lexxai/UltrasonicSensor/shema/shema-220.png

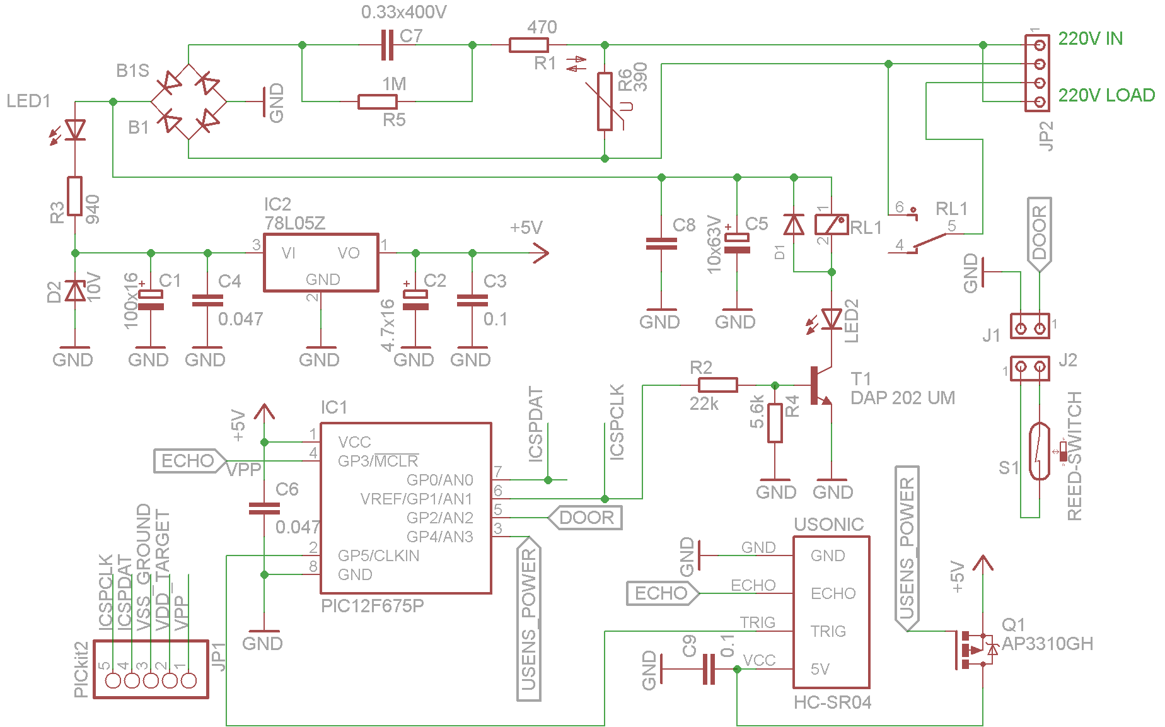
shema/shema-220.png
