lexxai/UltrasonicSensor/shema/ultrasonicsensor3.sch

## EAGLE design shema/ultrasonicsensor3.sch (2017-04-01)

Schematic: ultrasonicsensor3.sch

Parts:
C1: 50x10V; C/6032-28R
C3, C9: 0.1; C025-030X050
C5: 10x63V; C/6032-28R
C6: 0.047; C025-030X050
C8: C-EU025-030X050; C025-030X050
D1: DIODESOD-123; SOD-123
F1: SH22,5A
IC1: PIC12F675P; DIL8
J1, J2: MTA02-100; 10X02MTA
JP1: PICkit2; 1X05
JP2: MTA04-156; 1X4MTA
LED1, LED2, LED3: LED3MM
R2: 490R; 0207/2V
R4: 5.6k; 0207/2V
RL1: V23061-B1007-A401 SCHRACK; V23040201
S1: REED-SWITCH; MK6-5
T1: DAP 202 UM; TO92
USONIC: HC-SR04; HC-SR04_FOOTPRINT

Notes on the sheet:
220V LOAD
220V IN
Travel Charger Nokia AC-2E Input: ~ 100-240V/150mA Output: 5.3V/500mA
