lexxai/UltrasonicSensor/shema/ultrasonicsensor.sch

## EAGLE design shema/ultrasonicsensor.sch (2017-04-01)

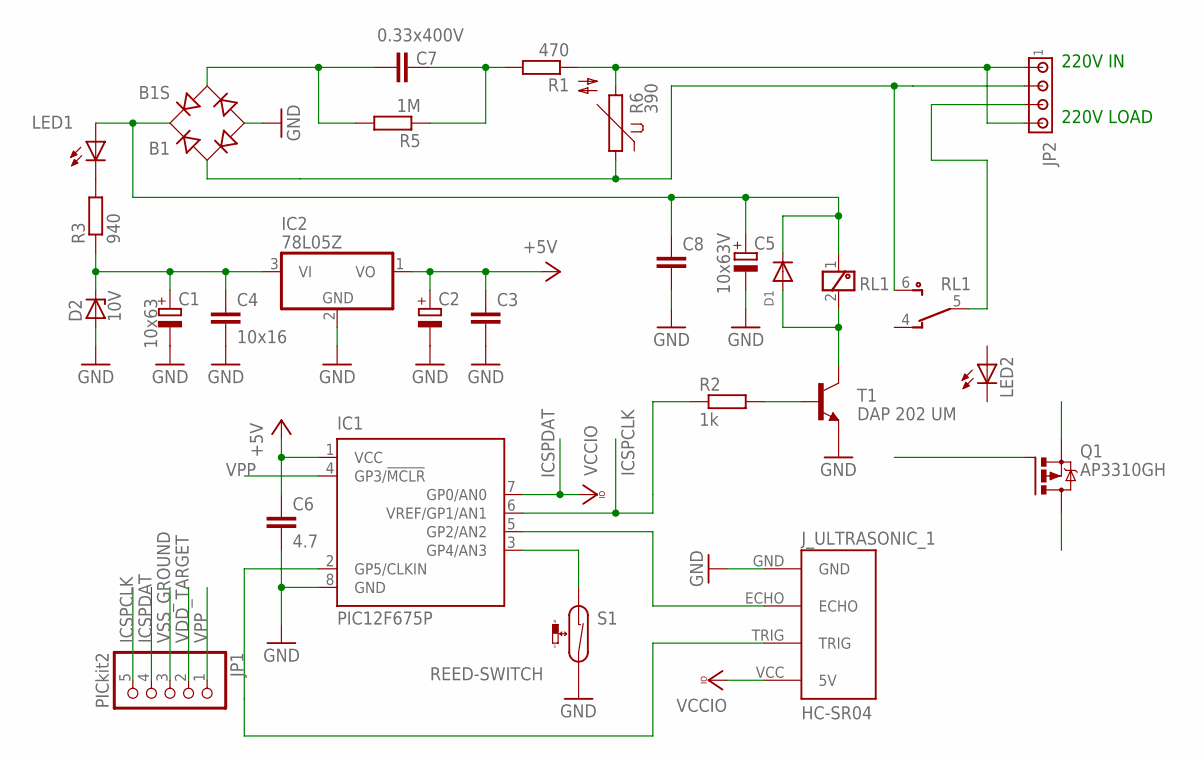
[picture p3: schematic ultrasonicsensor.sch]

Parts:
B1: B1S; MBS
C1: 10x63; C/6032-28R
C2: CPOL-EUC/6032-28R; C/6032-28R
C3, C8: C-EU025-030X050; C025-030X050
C4: 10x16; C025-030X050
C5: 10x63V; C/6032-28R
C6: 4.7; C025-030X050
C7: 0.33x400V; C025-030X050
D1: DIODESOD-123; SOD-123
D2: 10V; DO35Z10
IC1: PIC12F675P; DIL8
IC2: 78L05Z; TO92
JP1: PICkit2; 1X05
JP2: MTA04-156; 1X4MTA
J_ULTRASONIC_1: HC-SR04; HC-SR04_FOOTPRINT
LED1, LED2: LED3MM
R1: 470; 0207/2V
R2: 1k; 0207/2V
R3: 940; 0207/2V
R5: 1M; 0207/2V
R6: 390; S14K385
RL1: V23061-B1007-A401 SCHRACK; V23040201
S1: REED-SWITCH; MK6-5
T1: DAP 202 UM; TO92

Connections:
220-1: JP2.1, JP2.4, R1.1, R6.2
220-2: B1.AC1, JP2.2, R6.1, RL1.6
220-LOAD: JP2.3, RL1.5
+24V: C1.+, C4.1, D2.C, IC2.3 (VI), R3.1
GND: B1.-, C1.-, C2.-, C3.2, C4.2, C5.-, C6.2, C8.2, D2.A, IC1.8 (GND), IC2.2 (GND), J_ULTRASONIC_1.GND, S1.2, T1.1 (E)
ICSPCLK: IC1.6 (VREF/GP1/AN1), JP1.5, R2.1
ICSPDAT: IC1.7 (GP0/AN0), JP1.4
unnamed: IC1.5 (GP2/AN2), J_ULTRASONIC_1.ECHO
unnamed: IC1.2 (GP5/CLKIN), J_ULTRASONIC_1.TRIG
unnamed: R2.2, T1.2 (B)
unnamed: B1.+, C5.+, C8.1, D1.C, LED1.A, RL1.1
unnamed: IC1.3 (GP4/AN3), S1.1
unnamed: D1.A, RL1.2, T1.3 (C)
unnamed: LED1.K (C), R3.2
unnamed: C7.1, R1.2, R5.1
unnamed: B1.AC2, C7.2, R5.2
VCC: C2.+, C3.1, C6.1, IC1.1 (VCC), IC2.1 (VO)
VCCIO: J_ULTRASONIC_1.VCC (5V)
VDD_TARGET: JP1.2
VPP: IC1.4 (GP3/!MCLR), JP1.1
VSS_GROUND: JP1.3

Notes on the sheet:
220V LOAD
220V IN
