lexxai/UltrasonicSensor/user.c

/******************************************************************************/
/* Files to Include                                                           */
/******************************************************************************/

#if defined(__XC)
#include <xc.h>         /* XC8 General Include File */
#elif defined(HI_TECH_C)
#include <htc.h>        /* HiTech General Include File */
#endif

#include <stdint.h>         /* For uint8_t definition */
#include <stdbool.h>        /* For true/false definition */

#include "system.h"
#include "user.h"






/******************************************************************************/
/* User Functions                                                             */
/******************************************************************************/

/* <Initialize variables in user.h and insert code for user algorithms.> */

void InitApp(void) {
    /* TODO Initialize User Ports/Peripherals/Project here */

    /* Setup analog functionality and port direction */
    ANSEL = 0; //Digital IN
    
    ADCON0 = 0x00;         // Shut off the A/D Converter
    CMCON  = 0x07;         // Shut off the Comparator
    VRCON  = 0x00;         // Shut off the Voltage Reference

    MEASUREMODULE_TRIGGER_TRISBIT = TRISIO_MODE_OUTPUT; //OUT 
    MEASUREMODULE_ECHO_TRISBIT = TRISIO_MODE_INPUT; //IN

    //DOOR_SENSOR_TRISBIT = TRISIO_MODE_INPUT; //IN
    pinMode(DOOR_SENSOR_TRISBIT,TRISIO_MODE_INPUT);
    
    //LIGHT_RELAY_TRISBIT = TRISIO_MODE_OUTPUT; //OUT
    pinMode(LIGHT_RELAY_TRISBIT,TRISIO_MODE_OUTPUT);
    
    MEASUREMODULE_POWER_TRISBIT = TRISIO_MODE_OUTPUT; //OUT
    BUZZER_TRISBIT = TRISIO_MODE_OUTPUT; //OUT
    
#ifdef DEBUG_UART
    UART_OUT_TRISBIT = TRISIO_MODE_OUTPUT; //OUT
#endif


    /* Initialize peripherals */

    //WEAK PULL-UP for door sensor
    WPU = 0; //Pull-up disable for all ports
    pinModePullUP(DOOR_SENSOR_WPU,1);//DOOR_SENSOR_WPU = 1; //Pull-up enabled for door sensor port (reed switch)
    OPTION_REGbits.nGPPU = 0; // enable individual pull-ups


    /* Initialize TIMER 1 */

    T1CONbits.TMR1GE = 0; // disable timer1 gate.
    T1CONbits.TMR1CS = 0; // internal clock Fosc/4. Fosc/4= 4MHz/4 = 1Mhz
    T1CONbits.T1CKPS = 0x00; // prescaler timer1 1:1. 1:1 = 1Mhz
    T1CONbits.T1OSCEN = 0; // disable LP.
    T1CONbits.TMR1ON = 0; // disable timer1.

    /* Initialize TIMER 0 PRESCASLER FOR WATCHDOG */
    OPTION_REGbits.PSA = 1; // Use internal Watchdog timer ~18ms
    OPTION_REGbits.PS = WATCHDOG_PRESCALER_MAIN;

#ifdef DEBUG_UART
    //Timer 0
    OPTION_REGbits.PSA = 1; // Use TMR0 counting FOSC/4
    OPTION_REGbits.T0CS = 0; // Select TMR0 in Timer Mode (counting FOSC/4)
#endif

    /* Enable interrupts */
    GPIF = 0; //Clear GPIO On-Change Interrupt Flag
    IOC = MEASUREMODULE_ECHO_MASK; //Enable On-Change Interrupt GPIO for MEASUREMODULE_ECHO 
    GPIE = 1; //Enable GPIO On-Change Interrupt
    di(); //GIE = 0; //Global Interrupt disable

#ifdef DEBUG_UART
    init_serial();
#endif
}

#ifdef DEBUG_UART

void init_serial() {
    UART_OUT = SER_BIT; // make hi level
    LATGPIO_FLUSH;
    return;
}

void send_serial_byte(unsigned char data) {
    unsigned char i;
    i = 8; // 8 data bits to send

    //PortBShadow &= (!SER_BIT)<<TxPin
    //PORTB = PortBShadow;
    UART_OUT = !SER_BIT; // make start bit
    LATGPIO_FLUSH;
    TMR0 = (256 - SER_BAUD - 5); // load TMR0 value for first baud;
    while (TMR0 & (1 << 7)); // wait for baud

    while (i) // send 8 serial bits, LSB first
    {
        if (data & 1 << 0) UART_OUT = SER_BIT; // send data bit
        else UART_OUT = !SER_BIT;
        LATGPIO_FLUSH;
        data = (data >> 1); // rotate right to get next bit
        i--;
        TMR0 -= SER_BAUD; // load corrected baud value
        while (TMR0 & 1 << 7); // wait for baud
    }
    UART_OUT = SER_BIT; // make stop bit
    LATGPIO_FLUSH;
    TMR0 -= SER_BAUD; // wait a couple of baud for safety
    while (TMR0 & 1 << 7);
    TMR0 -= SER_BAUD; // wait a couple of baud for safety
    while (TMR0 & 1 << 7);
    return;
}

void send_serial_byte2(unsigned char data) {
    di();
    unsigned char i;
    i = 8; // 8 data bits to send

    //PortBShadow &= (!SER_BIT)<<TxPin
    //PORTB = PortBShadow;
    UART_OUT = !SER_BIT; // make start bit
    LATGPIO_FLUSH;
#define HALF_BIT_DELAY 44
#define BIT_DELAY 91
    _delay(BIT_DELAY);
    //while (TMR0 & (1 << 7)); // wait for baud

    while (i) // send 8 serial bits, LSB first
    {
        if (data & 1 << 0) UART_OUT = SER_BIT; // send data bit
        else UART_OUT = !SER_BIT;
        data = (data >> 1); // rotate right to get next bit
        i--;
        //TMR0 -= SER_BAUD; // load corrected baud value
        //while (TMR0 & 1 << 7); // wait for baud
        LATGPIO_FLUSH;
        _delay(BIT_DELAY);
    }
    UART_OUT = SER_BIT; // make stop bit
    LATGPIO_FLUSH;
    _delay(BIT_DELAY);
    ei();
    return;
}

#endif

void checkMeasureModulePowerforApply(void) {
#ifndef DEBUG_UART
    if (MEASUREMODULE_POWER == !MeasureModulePower) { // only change state
        MEASUREMODULE_POWER = MeasureModulePower;
#else
    MEASUREMODULE_POWER = MeasureModulePower_on;
#endif                
        LATGPIO_FLUSH;
        __delay_us(20); //10uS Delay for start module
#ifndef DEBUG_UART     
    }
#endif 
    return;
}

void WDT_SLEEP(void) {
#if (UseWatchDogForDelay)
    //SLEEP THAT SIMULATE APPROXIMATLY WAIT ECHO ,WDT RC ~144ms, WAIT ECHO 142ms
    //GIE = 0; //Global Interrupt DISABLE
    CLRWDT();
    //tune watchdog time to sleep time approx. equal one loop delay
    OPTION_REGbits.PS = WATCHDOG_PRESCALER_SLEEP; //~144ms 
    SLEEP(); // Included CLRWDT. WAKEUP BY WATCHDOG TIMEOUT  
    NOP();
    //now recover general watchdog time
    OPTION_REGbits.PS = WATCHDOG_PRESCALER_MAIN; //~576ms 
    CLRWDT();
    //GIE = 1; //Global Interrupt Enable
#else
    __delay_ms(ECHO_WAIT); // WAIT ECHO
#endif
    return;
}

 
