lexxai/UltrasonicSensor/(commit log)

2015-05-17 interrupt ok timer of state on
2015-05-18 added POWERING of ULTRASOUND Module
2015-06-28 added control of Pull-up for door sensor controll reel-switch
2015-06-28 added shema
    [ultrasonicsensor.sch]
2015-07-03 added power control of usound module
    [ultrasonicsensor.sch]
2015-07-05 tune distance tune power line in sheme
2015-07-06 debug rs232 uart distance output
2015-08-15 // In General: // Object not present {0...DISTANCE_LIMIT_LOW} || {DISTANCE_SET...DISTANCE_LIMIT_HIGH} // Object present {DISTANCE_LIMIT_LOW...DISTANCE_SET} || {DISTANCE_LIMIT_HIGH...INFINITY} // This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
    tuned time off to 15 sec
2015-08-20 wakeup from sleep by watchdog timer
2015-08-20 moved wakeup from sleep by watchdog timer to function
2015-08-22 added reset count action present for case when SafeOffRelay state is for prevent overflow counter
    [main.c]
2015-08-24 shema images
    [ultrasonicsensor3.sch]
2015-08-26 remove production dirs
    [UltrasonisSensor.X.production.obj]
2017-03-20 Added 'present human' button
    Button with led.
    By pressing button, program should know that human present in case when program have wrong detection of missing human
    [ultrasonicsensor4.sch]
2017-04-01 removed from git work files
    [UltrasonisSensor.X.production.obj]
2017-04-01 modified: ultrasonicsensor4.sch
    [ultrasonicsensor4.sch]
2017-04-04 shema. added BUZZER
    [ultrasonicsensor4.sch]
2017-04-04 added code for HUMAN BUTTON and BUZZER
    [configuration_bits.c, interrupts.c, main.c, user.c, user.h]
2017-04-04 shema. HUMMAN BODY BUTTON and BUZZER
2017-04-06 tuned bug pressed button at start do switch off
    [main.c]
2017-04-06 forgot uncoment relay off for safety part
